MukhanovaE/Nano_sample_holders/README.md

Cable schematic
