MukhanovaE/Nano_sample_holders/support_angle/README.md

изображение
