MukhanovaE/Nano_sample_holders/holders_2023/README.md

SH1
