MukhanovaE/Nano_sample_holders/PCBs/12_pins/README.md

изображение
