MukhanovaE/Nano_sample_holders/PCBs/4_pin/README.md

PCBs for 4-pin holder:

  5 mm chip
  
  7 mm chip

изображение
