MukhanovaE/Nano_sample_holders/PCBs/8_pins/README.md

8 pins holder:

  5 mm chip (original design of 2023)
  
  7 mm chip

изображение
