MukhanovaE/Nano_sample_holders/holders_2023/holders_description.txt

1st generation: ---2023--- 

  8-pin holder: fabricated in nanotalo workshop
