MukhanovaE/Nano_sample_holders/holders_2023/8_pins_1st_generation/8pins_bottom_part_holder.stp

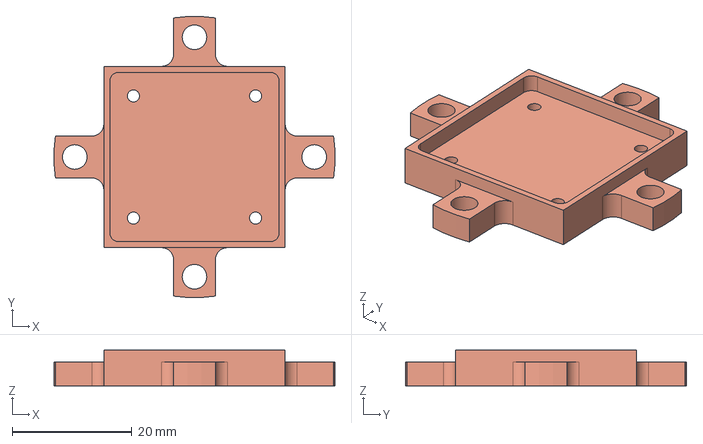
[picture p9: CAD file, 2024-10-09]
holders_2023/8_pins_1st_generation/8pins_bottom_part_holder.stp
46.9 x 46.9 x 6.00 mm
