MukhanovaE/Nano_sample_holders/mu_shields/lid_for_mu_shield_2_sizes.SLDPRT

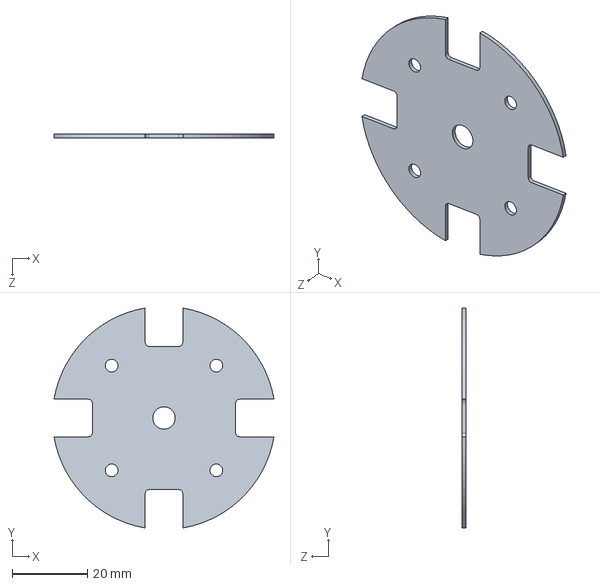
[picture p10: CAD file, 2024-09-30]
mu_shields/lid_for_mu_shield_2_sizes.SLDPRT
58.7 x 58.7 x 1.02 mm
