MukhanovaE/Nano_sample_holders/PCBs/12_pins/PCB_7x7_12pins.DXF

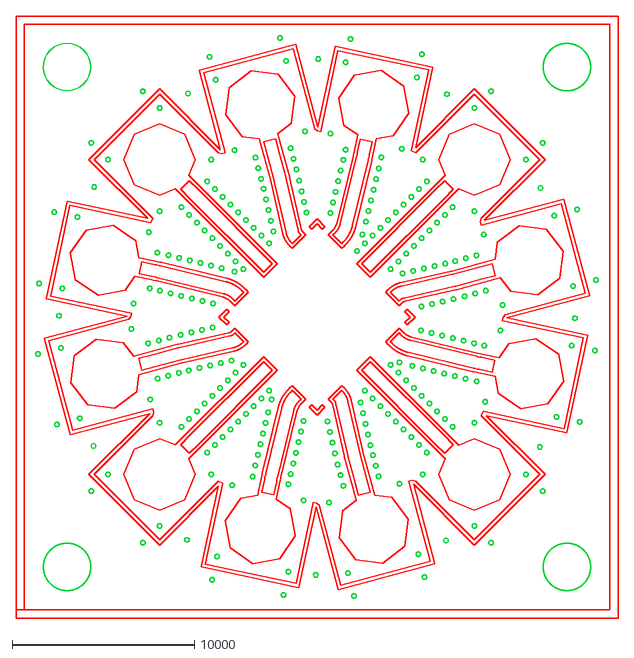
[picture p11: CAD file, 2024-09-30]
PCBs/12_pins/PCB_7x7_12pins.DXF
33000.0 x 33000.0
