MukhanovaE/Nano_sample_holders/PCBs/4_pin/PCB_7x7_4pins.dxf

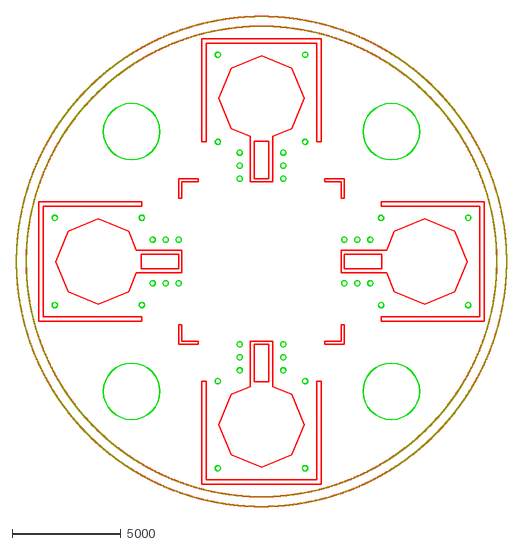
[picture p12: CAD file, 2024-09-30]
PCBs/4_pin/PCB_7x7_4pins.dxf
22500.0 x 22500.0
