MukhanovaE/Nano_sample_holders/PCBs/8_pins/PCB_5x5_8pins_submittef.dxf

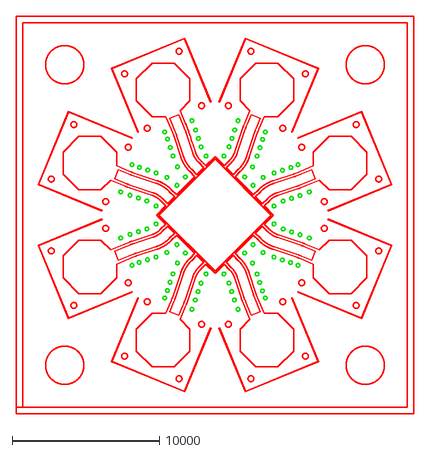
[picture p13: CAD file, 2024-09-30]
PCBs/8_pins/PCB_5x5_8pins_submittef.dxf
27000.0 x 27000.0
