MukhanovaE/Nano_sample_holders/shield_copper_mount_base/mount_base.SLDPRT

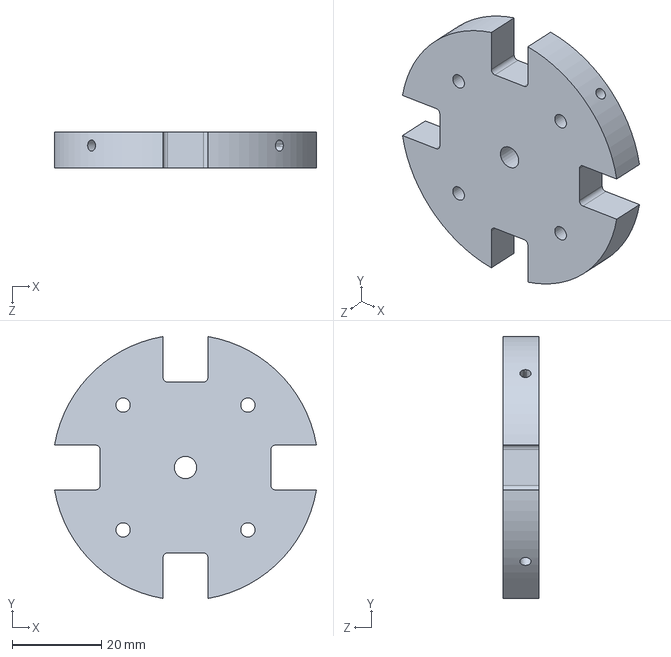
[picture p14: CAD file, 2024-09-30]
shield_copper_mount_base/mount_base.SLDPRT
58.7 x 58.7 x 8.00 mm
