MukhanovaE/Nano_sample_holders/support_angle/angle_mount.SLDPRT

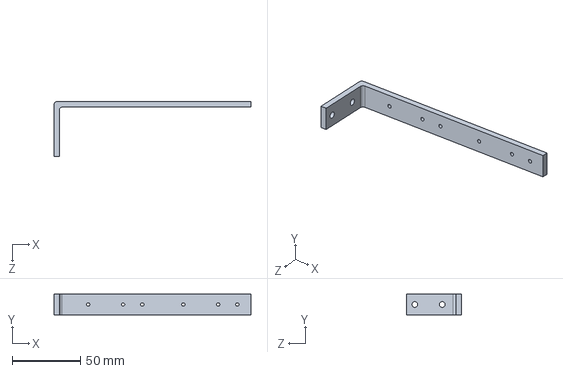
[picture p15: CAD file, 2024-09-30]
support_angle/angle_mount.SLDPRT
144.0 x 15.0 x 40.0 mm
