MukhanovaE/Nano_sample_holders/holders_2023/8_pins_1st_generation/8pins_top_part_holder.stp

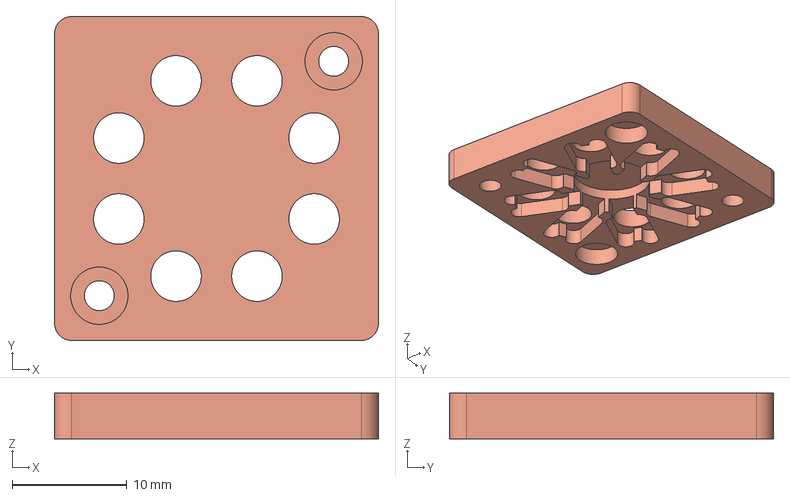
[picture p16: CAD file, 2024-10-09]
holders_2023/8_pins_1st_generation/8pins_top_part_holder.stp
28.2 x 28.2 x 4.00 mm
