MukhanovaE/Nano_sample_holders/mu_shields/mu_shield_2_sizes.SLDPRT

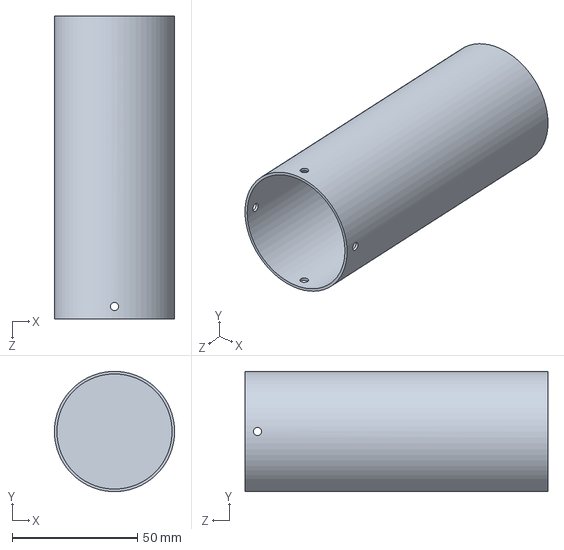
[picture p17: CAD file, 2024-09-30]
mu_shields/mu_shield_2_sizes.SLDPRT
48.0 x 48.0 x 121.0 mm
