MukhanovaE/Nano_sample_holders/PCBs/12_pins/PCB_10x10_12pins.DXF

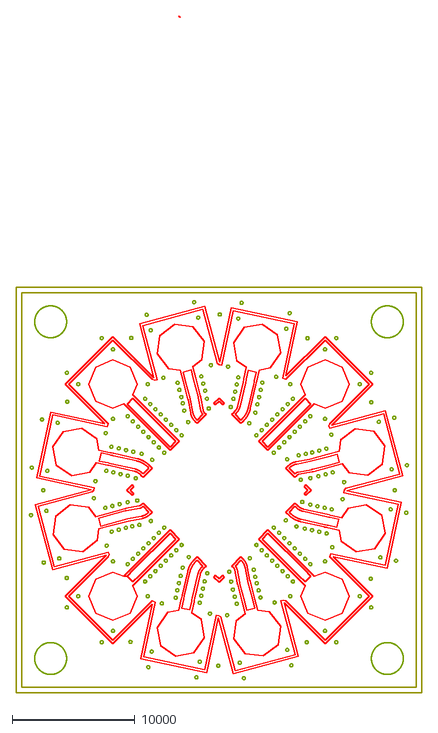
[picture p18: CAD file, 2024-09-30]
PCBs/12_pins/PCB_10x10_12pins.DXF
33000.0 x 55075.8
