MukhanovaE/Nano_sample_holders/PCBs/4_pin/PCB_5x5_4pins.DXF

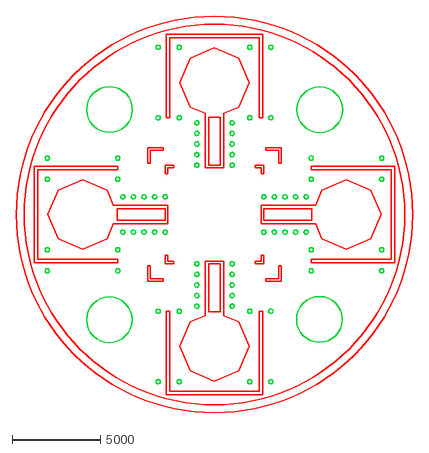
[picture p19: CAD file, 2024-09-30]
PCBs/4_pin/PCB_5x5_4pins.DXF
22500.0 x 22500.0
