MukhanovaE/Nano_sample_holders/PCBs/8_pins/PCB_7x7_8pins.dxf

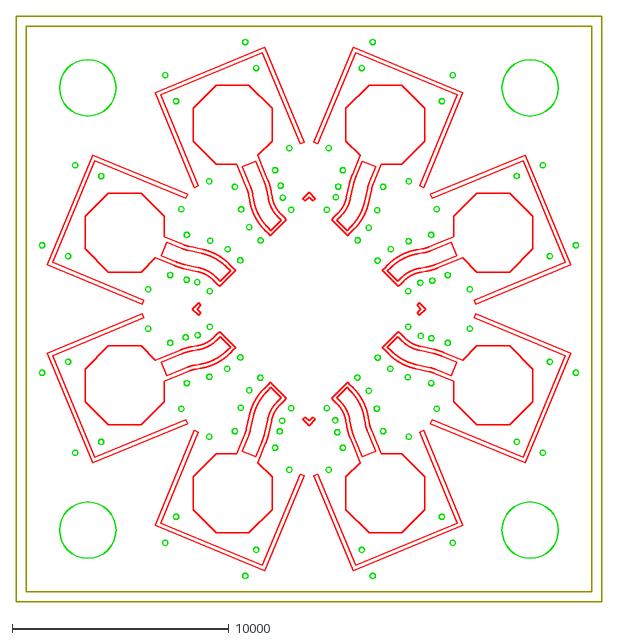
[picture p20: CAD file, 2024-09-30]
PCBs/8_pins/PCB_7x7_8pins.dxf
27000.0 x 27000.0
