MukhanovaE/Nano_sample_holders/(list of files, cad)

Other CAD files:
holders_2023/8_pins_1st_generation/Connector.ipt
holders_2023/8_pins_1st_generation/Connector_MIR.ipt
holders_2023/8_pins_1st_generation/PCB.ipt
holders_2023/8_pins_1st_generation/PCB_ASSY.iam
support_angle/angle_mount_inner.SLDDRW
