MukhanovaE/Nano_sample_holders/support_angle/angle_mount_inner.pdf

E E

F F

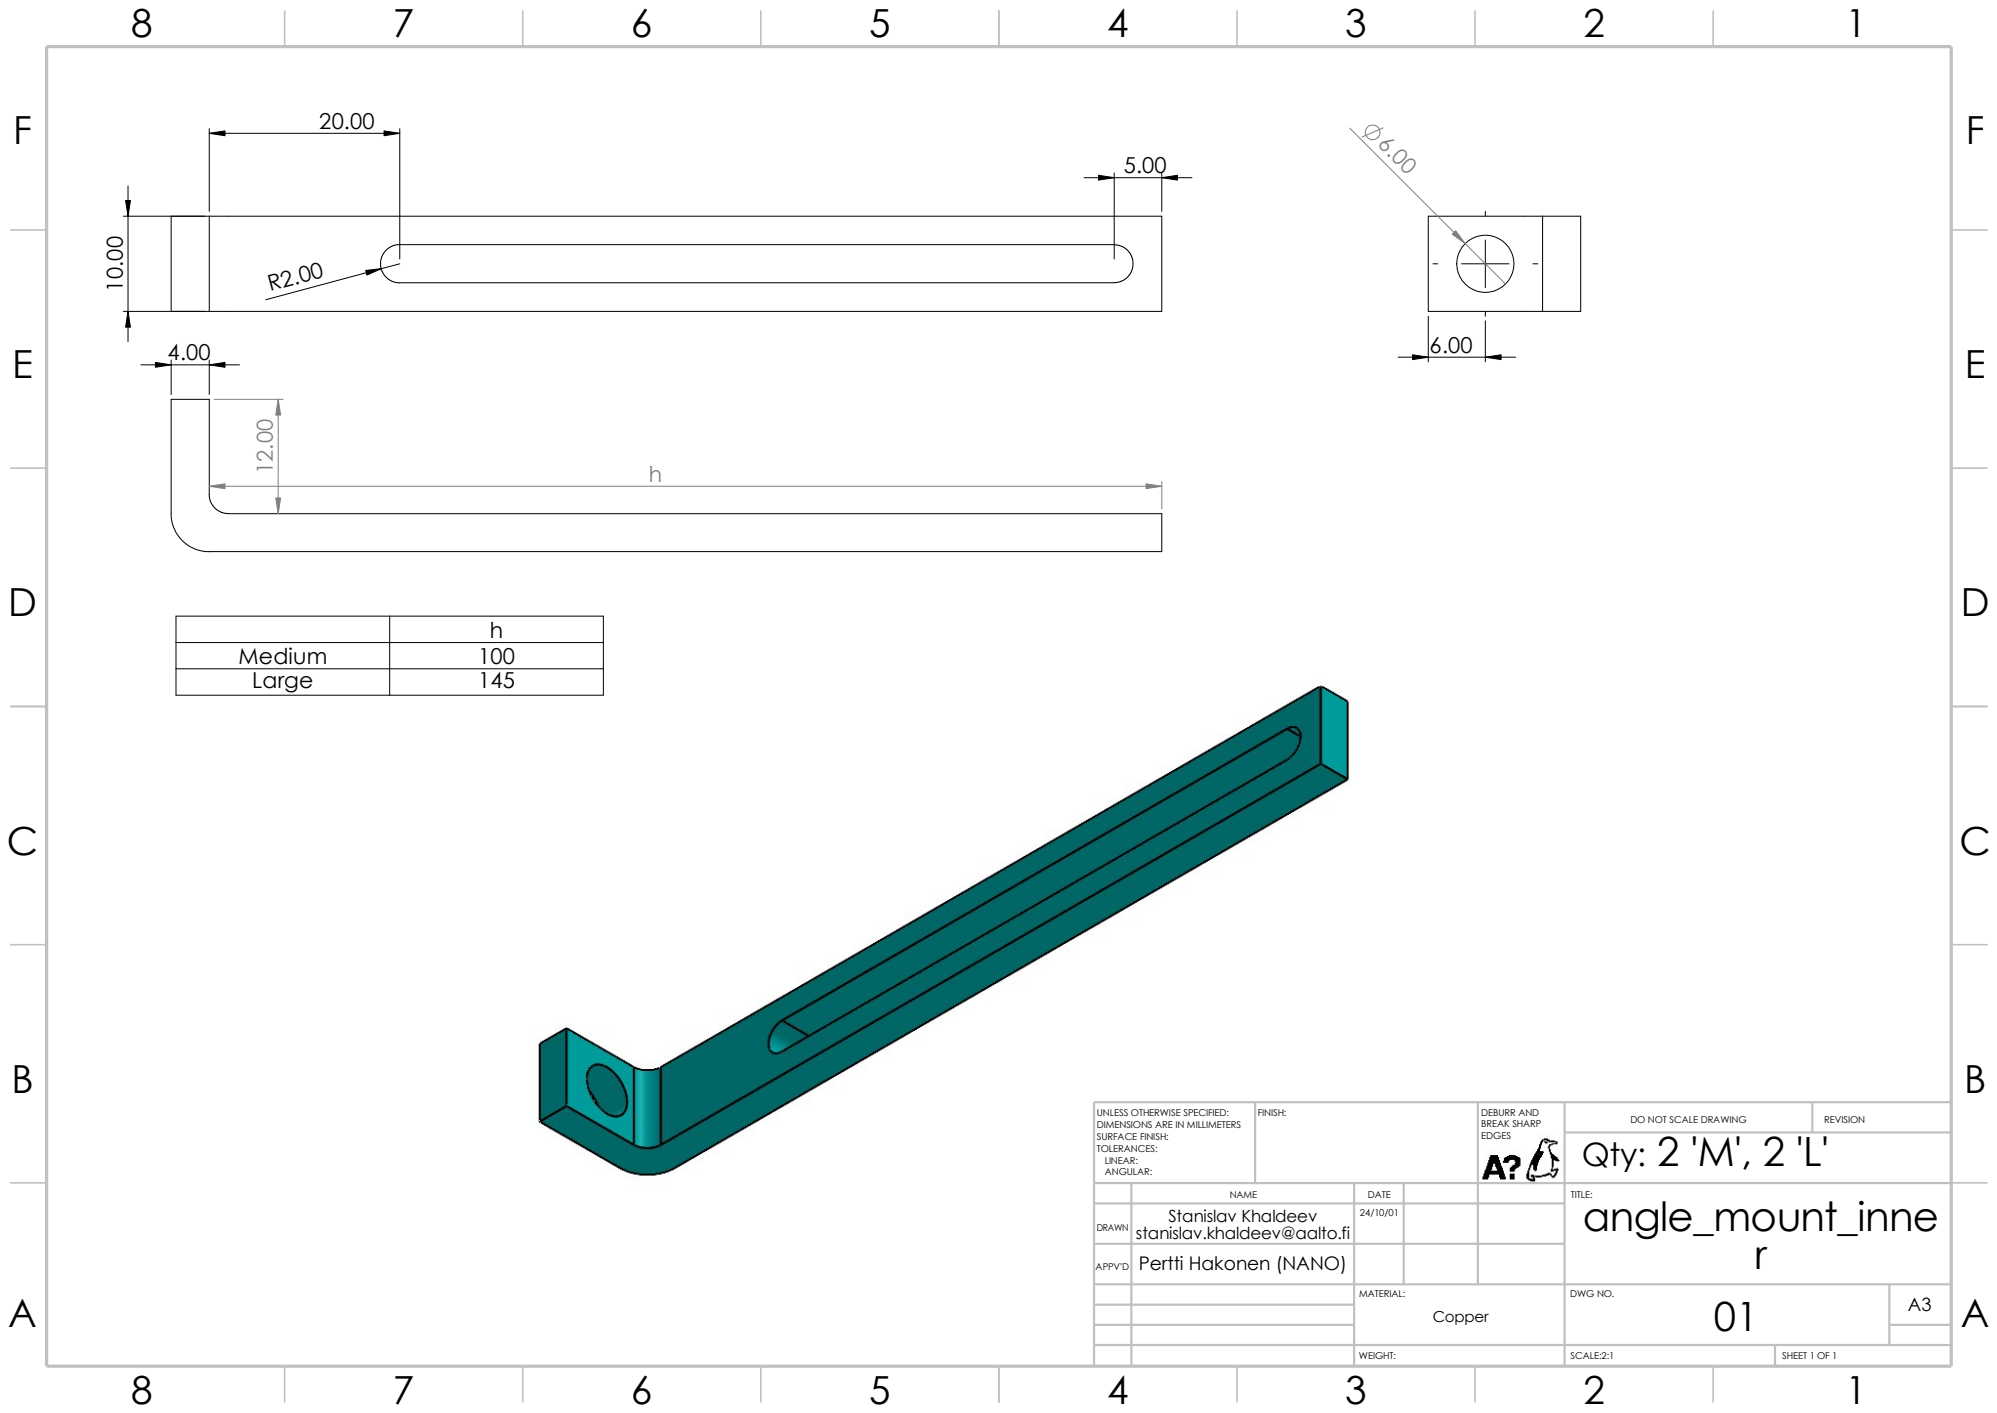
[picture p21: page 1]
Qty:; FINISH:; EDGES; DO NOT SCALE DRAWING; REVISION; BREAK SHARP; DEBURR AND

Medium | 100
Large | 145

UNLESS OTHERWISE SPECIFIED:
DIMENSIONS ARE IN MILLIMETERS
SURFACE FINISH:
TOLERANCES:
LINEAR:
ANGULAR:

NAME | DATE | | | TITLE: angle_mount_inne r
DRAWN | Stanislav Khaldeev stanislav.khaldeev@aalto.fi | 24/10/01

APPV'D | Pertti Hakonen (NANO)

MATERIAL: | DWG NO. 01 | A3 Copper

WEIGHT: | SCALE:2:1 | SHEET 1 OF 1
