MukhanovaE/Nano_sample_holders/mu_shields/shield_lid.pdf

E E

F F

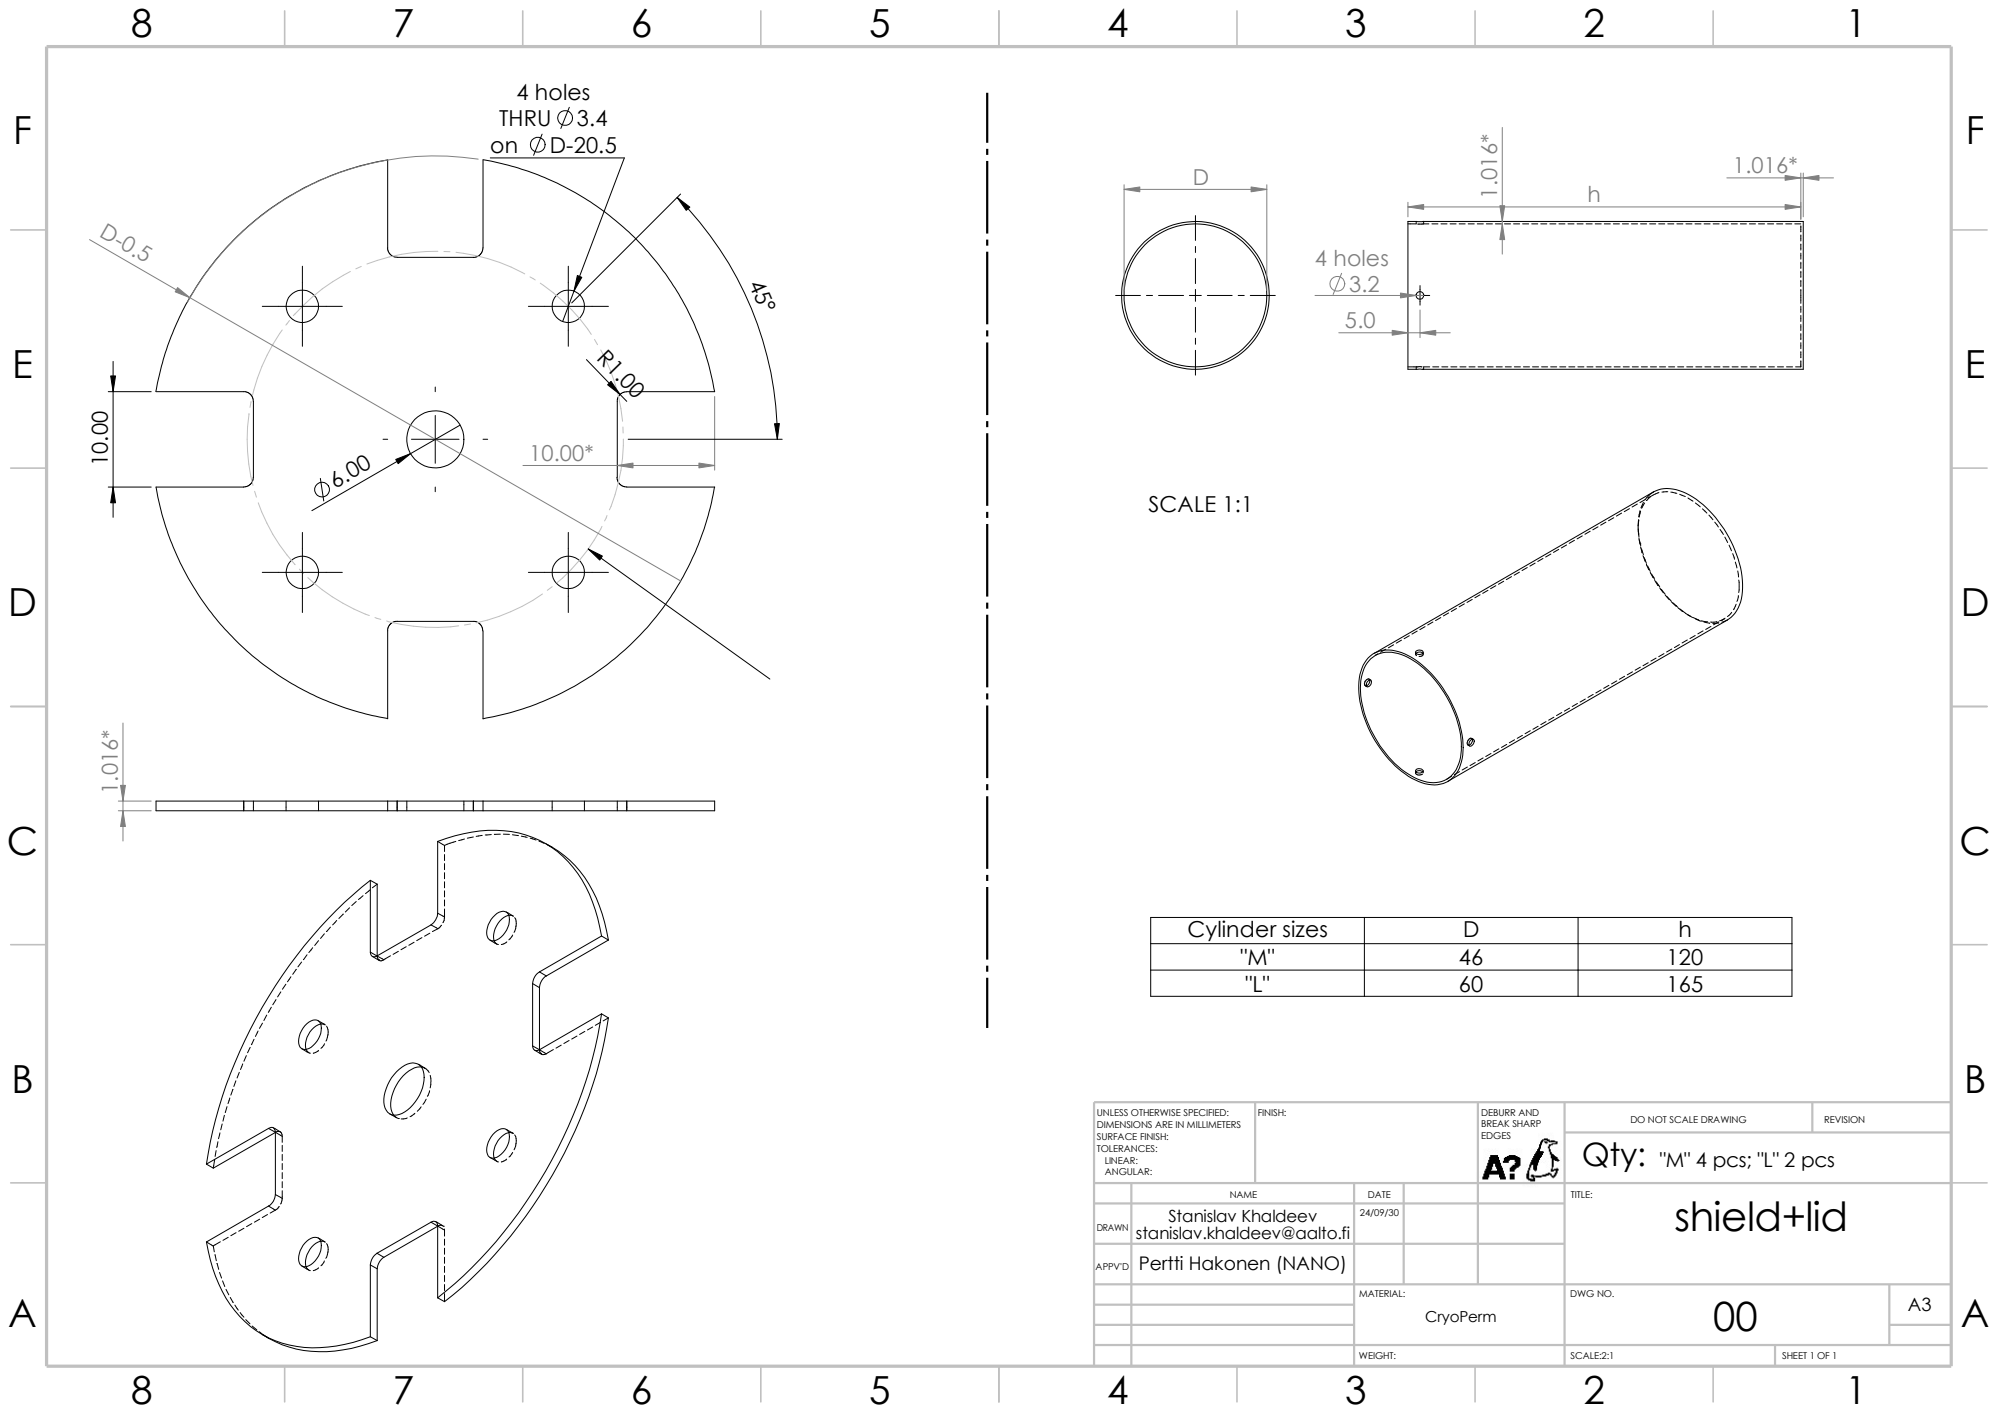
[picture p22: page 1]
ANGULAR:; WEIGHT:; FINISH:; EDGES; DO NOT SCALE DRAWING; REVISION; SCALE:2:1; SHEET 1 OF 1; LINEAR:; Qty:; BREAK SHARP; DEBURR AND; "M" 4 pcs; "L" 2 pcs; SCALE 1:1; 4 holes THRU 3.4 on; 4 holes

Cylinder sizes | D | h
"M" | 46 | 120
"L" | 60 | 165

UNLESS OTHERWISE SPECIFIED:
DIMENSIONS ARE IN MILLIMETERS
SURFACE FINISH:
TOLERANCES:

NAME | DATE | | | TITLE: shield+lid

DRAWN | Stanislav Khaldeev stanislav.khaldeev@aalto.fi | 24/09/30

APPV'D | Pertti Hakonen (NANO)

MATERIAL: CryoPerm | DWG NO. 00 | A3
