MukhanovaE/Nano_sample_holders/shield_copper_mount_base/copper_base.pdf

E E

F F

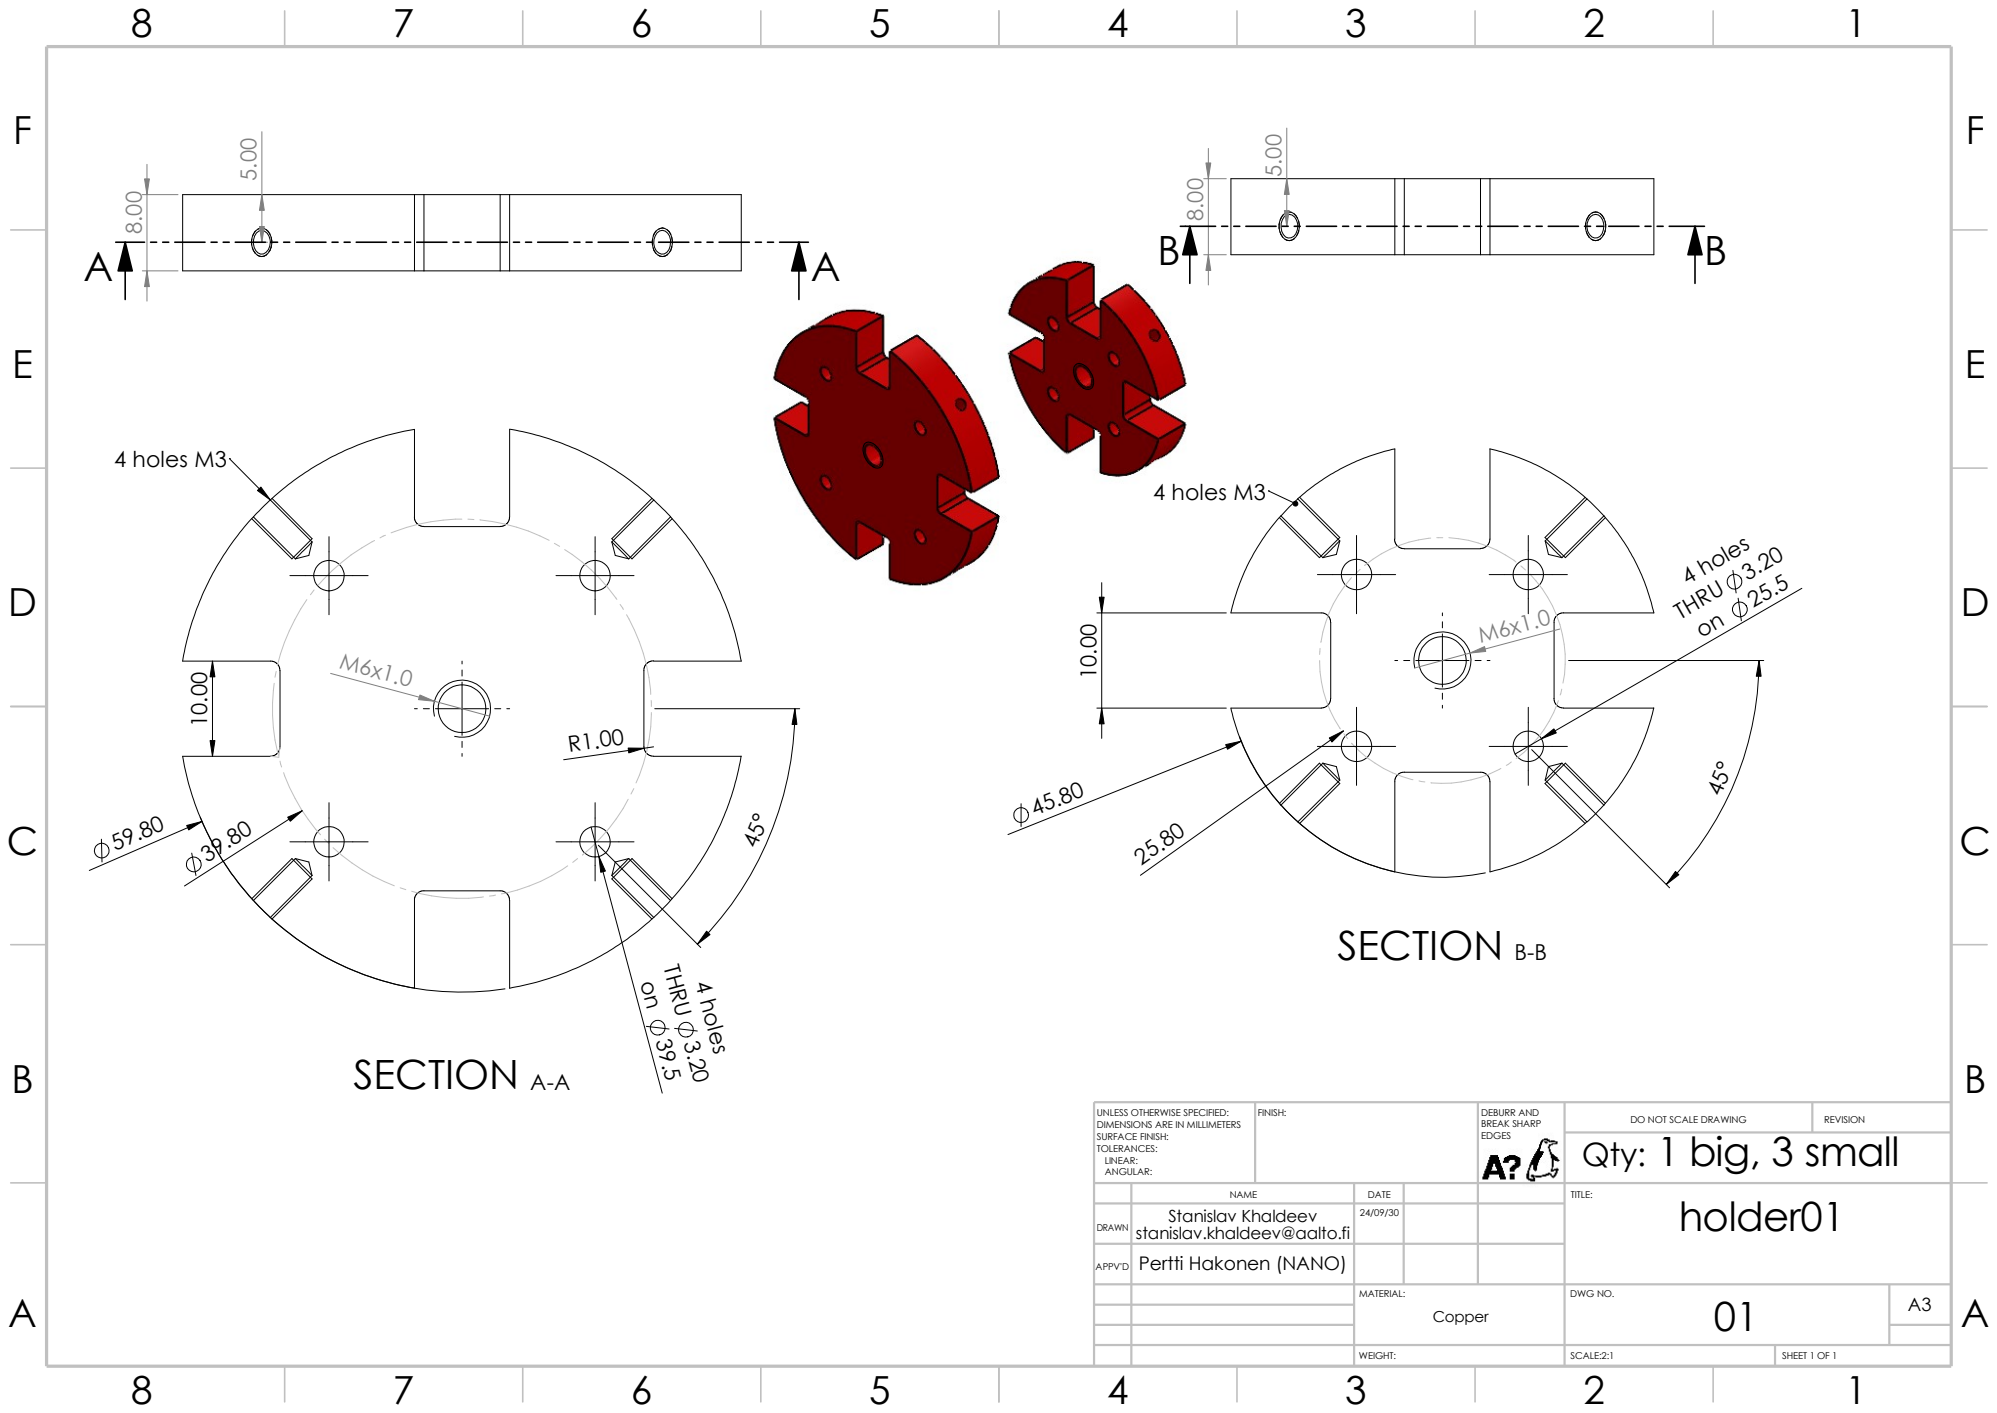
[picture p23: page 1]
Qty:; FINISH:; EDGES; DO NOT SCALE DRAWING; REVISION; BREAK SHARP; DEBURR AND; 1 big, 3 small ⁸.00; SECTION A-A; 4 holes M3; 4 holes; THRU; SECTION B-B; 4 holes THRU 3.20

UNLESS OTHERWISE SPECIFIED:
DIMENSIONS ARE IN MILLIMETERS
SURFACE FINISH:
TOLERANCES:
LINEAR:
ANGULAR:

NAME | DATE | | | TITLE: holder01

DRAWN | Stanislav Khaldeev stanislav.khaldeev@aalto.fi | 24/09/30

APPV'D | Pertti Hakonen (NANO)

MATERIAL: | DWG NO. 01 | A3 Copper

WEIGHT: | SCALE:2:1 | SHEET 1 OF 1
