MukhanovaE/Nano_sample_holders/support_angle/angle_mount.pdf

E E

F F

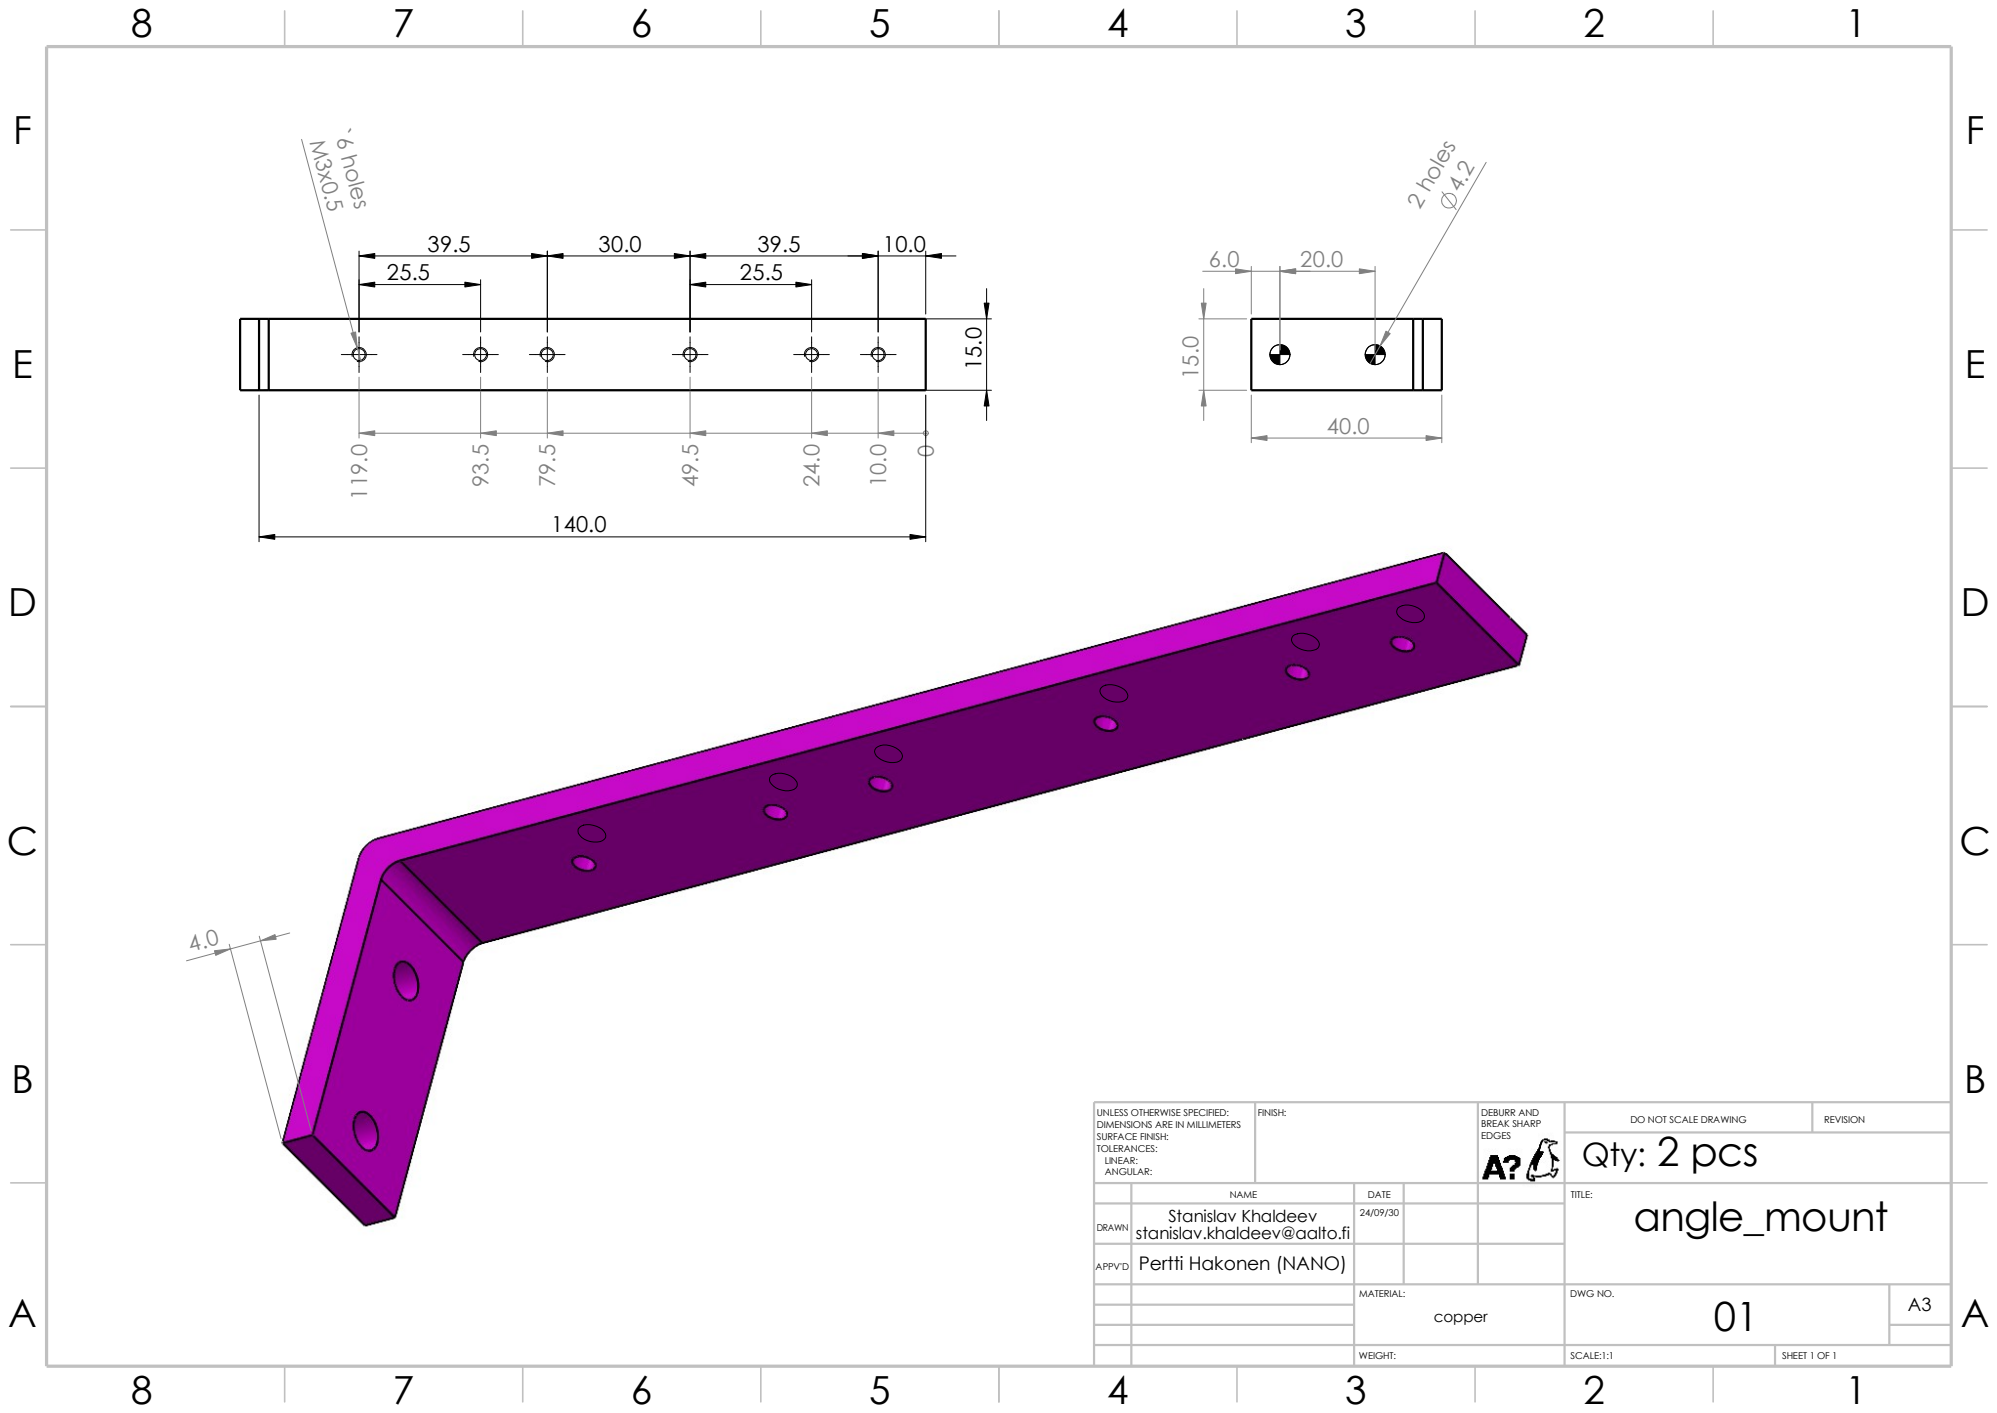
[picture p24: page 1]
WEIGHT:; FINISH:; EDGES; DO NOT SCALE DRAWING; REVISION; SCALE:1:1; Qty:; SHEET 1 OF 1; BREAK SHARP; DEBURR AND; 2 pcs; `6 holes M3x0.5 15.0; 2 holes 4.2

UNLESS OTHERWISE SPECIFIED:
DIMENSIONS ARE IN MILLIMETERS
SURFACE FINISH:
TOLERANCES:
LINEAR:
ANGULAR:

NAME | DATE | | | TITLE: angle_mount

DRAWN | Stanislav Khaldeev stanislav.khaldeev@aalto.fi | 24/09/30

APPV'D | Pertti Hakonen (NANO)

MATERIAL: copper | DWG NO. | A3
