MukhanovaE/Nano_sample_holders/holders_2023/8_pins_1st_generation/8_pins_1st_generation_full_assambly.pdf

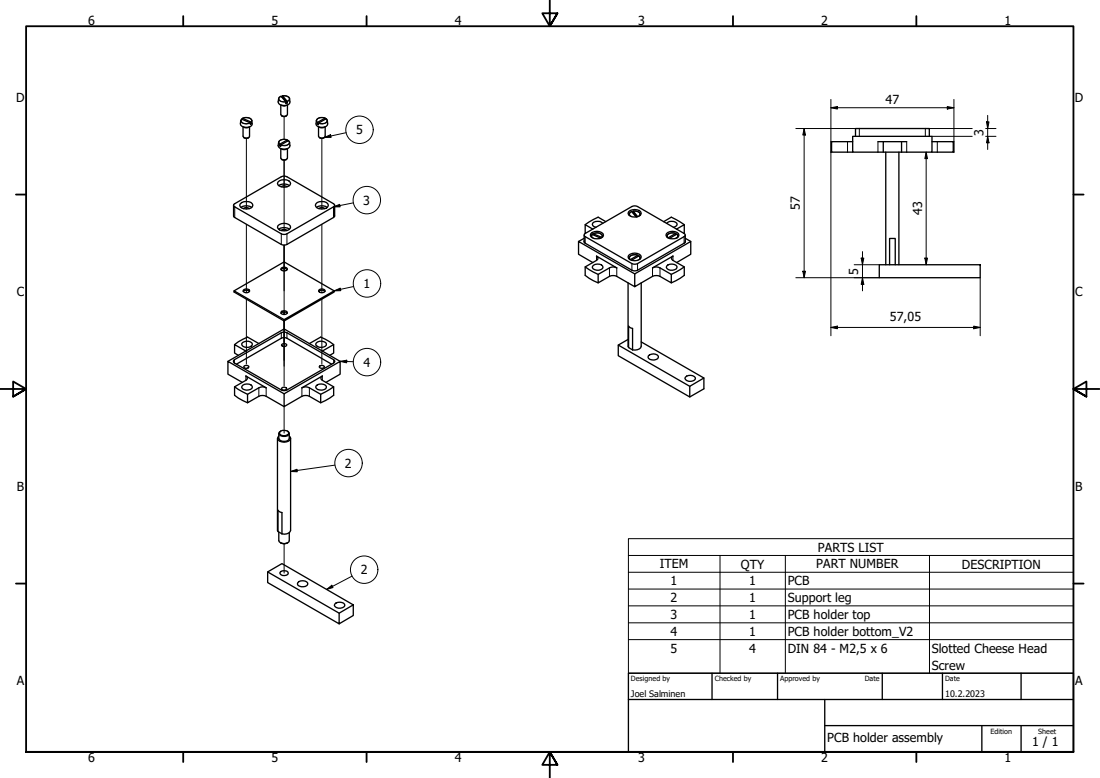
[picture p25: page 1]
PARTS LIST

ITEM | QTY | PART NUMBER | DESCRIPTION
1 | 1 | PCB
2 | 1 | Support leg
3 | 1 | PCB holder top
4 | 1 | PCB holder bottom_V2
5 | 4 | DIN 84 - M2,5 x 6 | Slotted Cheese Head Screw

Designed by Joel Salminen | Checked by | Approved by Date | | Date 10.2.2023

PCB holder assembly
