MukhanovaE/Nano_sample_holders/holders_2024/4_pin/4_pins_full.pdf

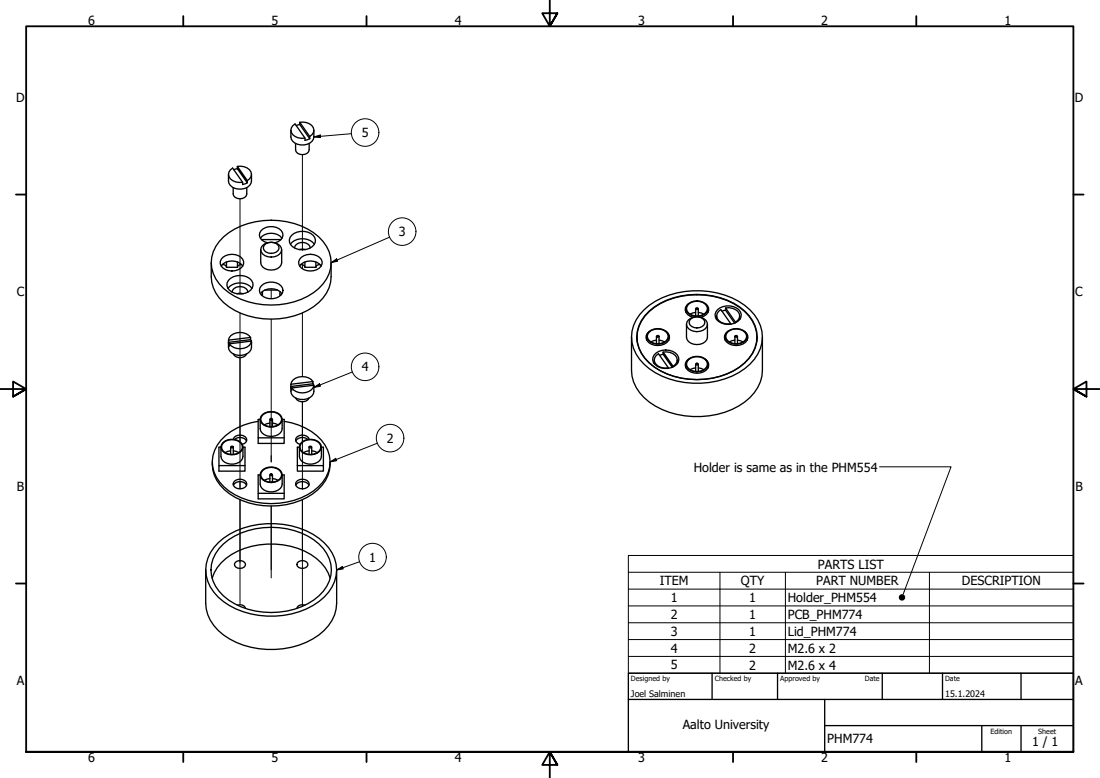
[picture p26: page 1]
PARTS LIST

Holder is same as in the PHM554

ITEM | QTY | PART NUMBER | DESCRIPTION
1 | 1 | Holder_PHM554
2 | 1 | PCB_PHM774
3 | 1 | Lid_PHM774
4 | 2 | M2.6 x 2
5 | 2 | M2.6 x 4

Designed by Joel Salminen | Checked by | Approved by Date | | Date 15.1.2024

Aalto University

PHM774 | Edition | Sheet 1 / 1
