MukhanovaE/Nano_sample_holders/support_column/Support_block_for_original_holder.pdf

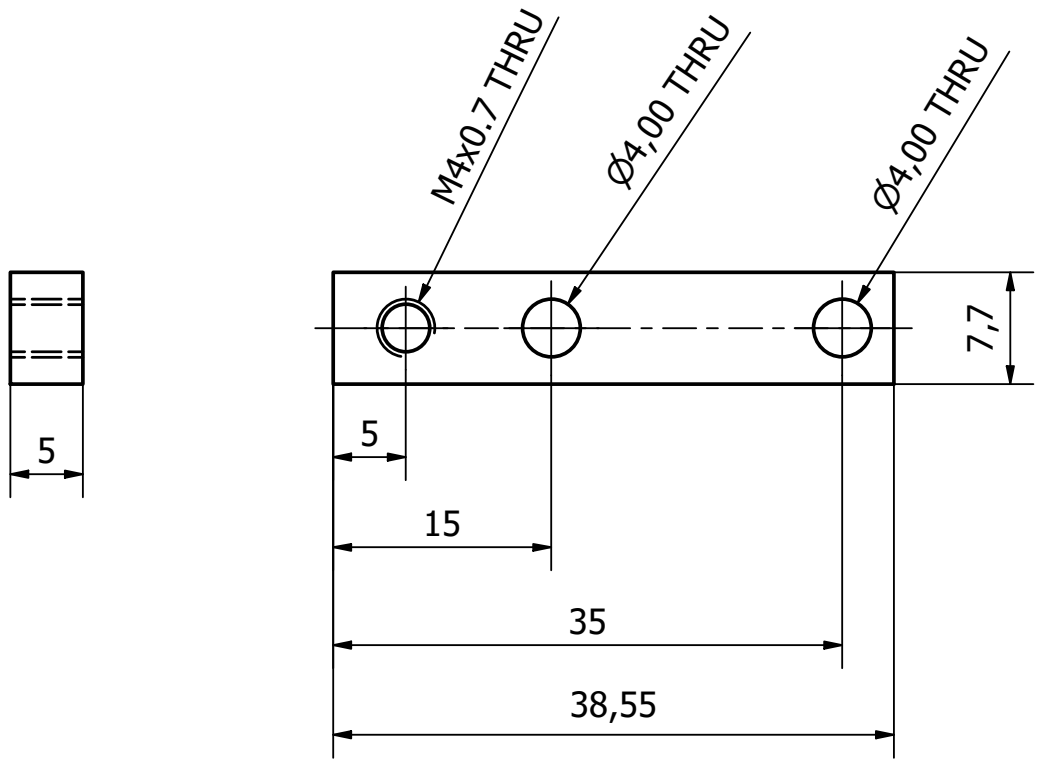
[picture p27: page 1]
Support block; Joel Salminen; Designed by; Checked by; Approved by; Date; M4x0.7 THRU; ⌀4,00 THRU; 00 THRU
