MukhanovaE/Nano_sample_holders/support_column/Support_column_for_original_holder.pdf

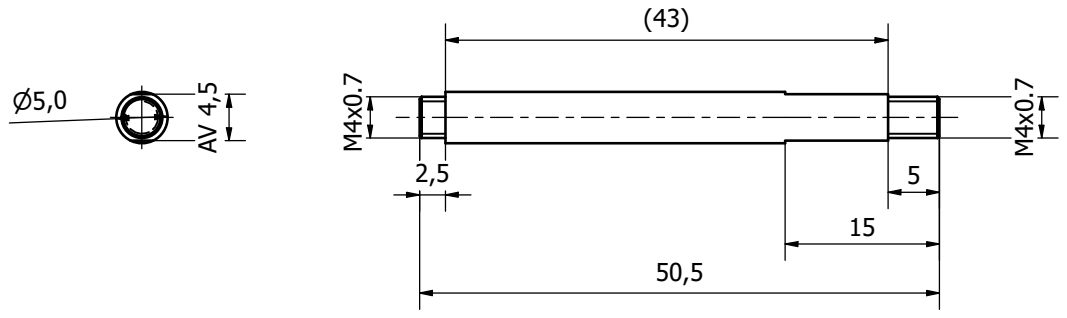
[picture p28: page 1]
Support column; Joel Salminen; Designed by; Checked by; Approved by; Date
