MukhanovaE/Nano_sample_holders/support_column/Support_column.pdf

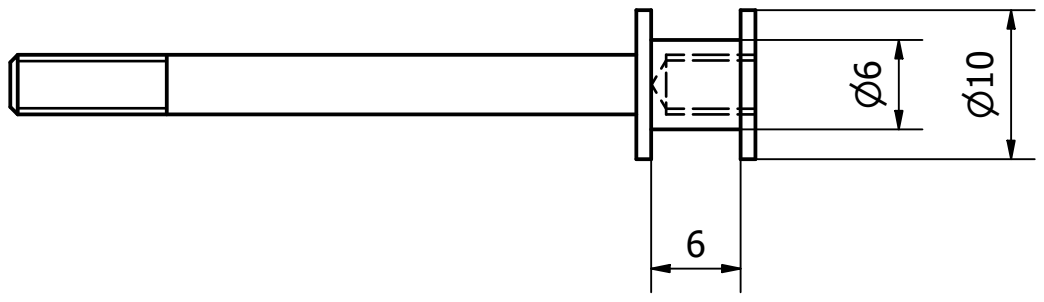
[picture p29: page 1]
Center post; Joel Salminen; Designed by; Checked by; Approved by; Date
