MukhanovaE/Nano_sample_holders/holders_2023/8_pins_1st_generation/8pins_bottom_part_holder.pdf

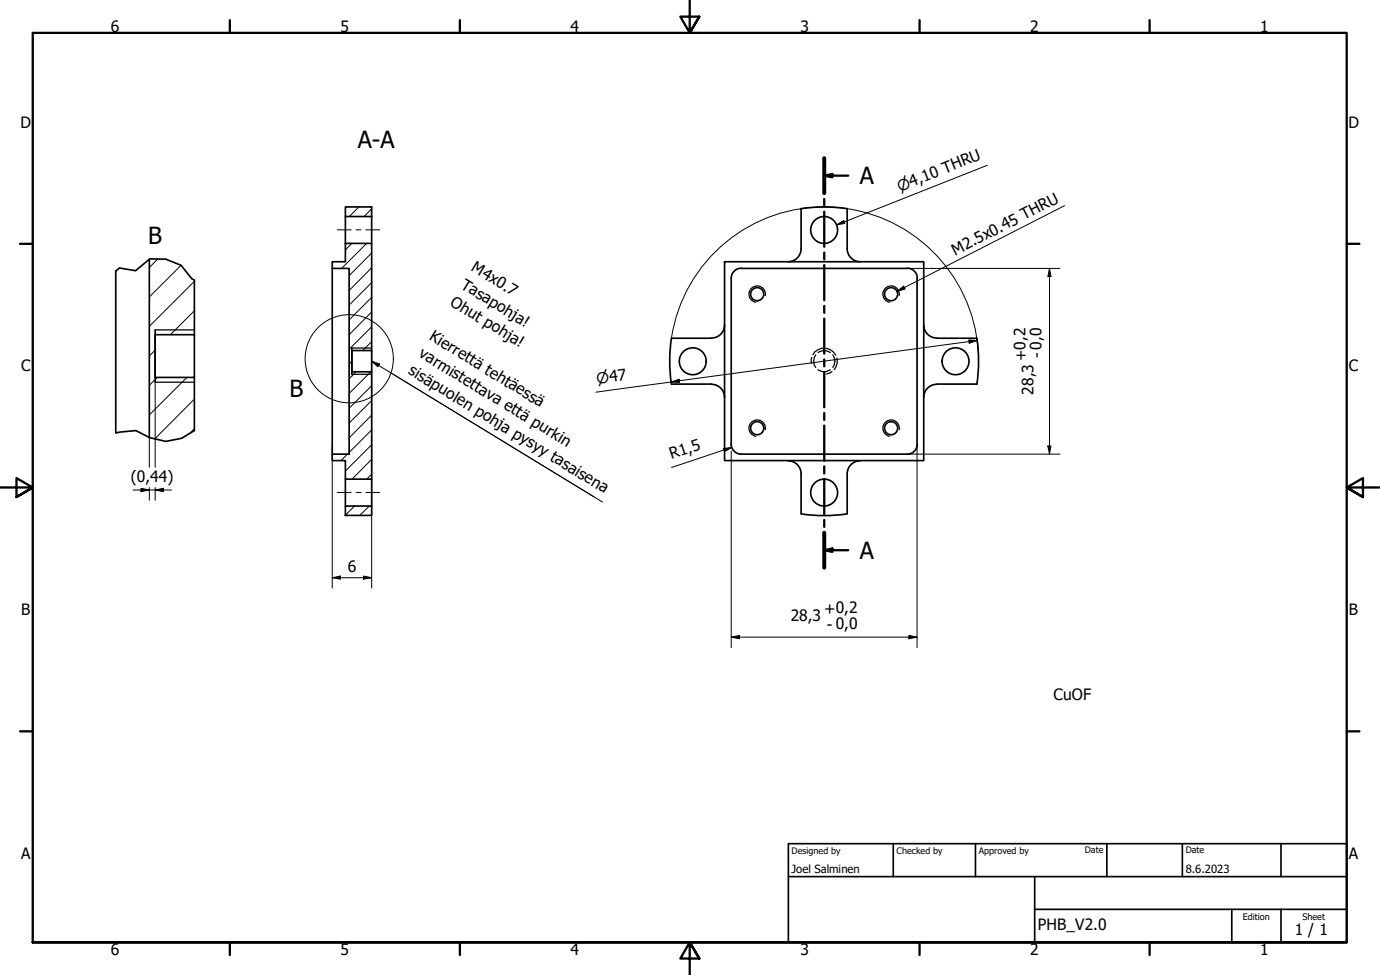
[picture p30: page 1]
Joel Salminen; Designed by; Checked by; Approved by; Date; ⌀4,10 THRU; M2.5x0.45 THRU; Ohut pohja!; Kierrettä tehtäessä

varmistettava että purkin

sisäpuolen pohja pysyy tasaisena
