MukhanovaE/Nano_sample_holders/holders_2023/8_pins_1st_generation/8pins_top_part_holder.pdf

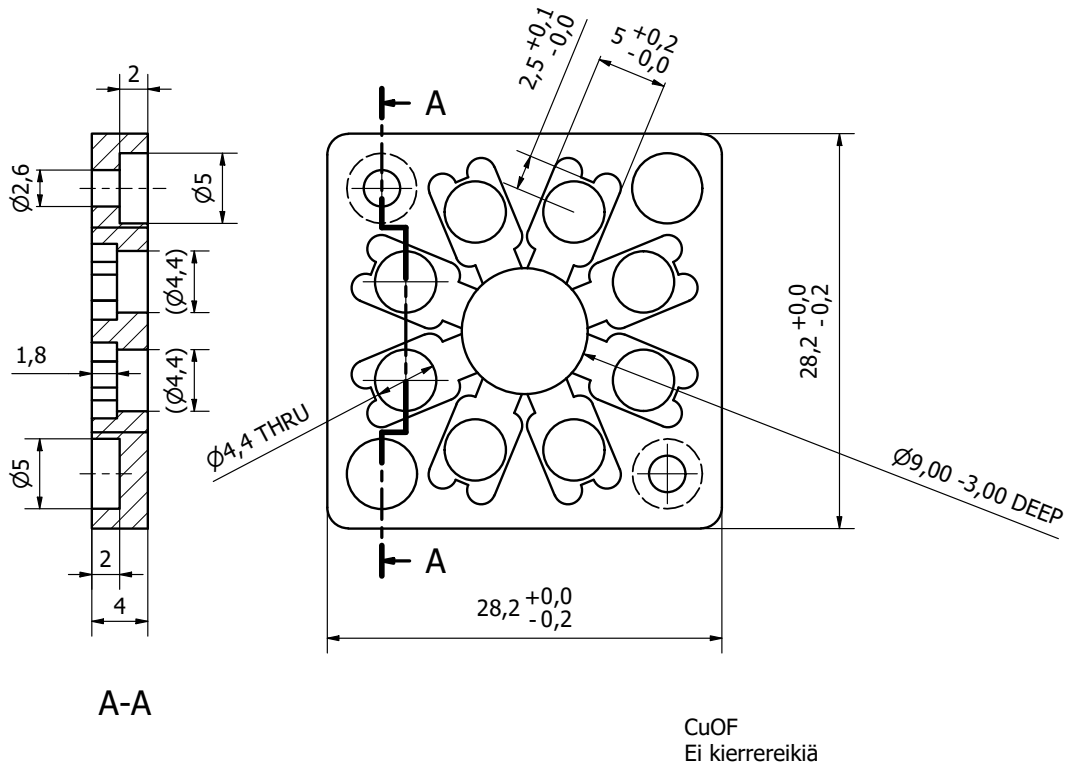
[picture p31: page 1]
Joel Salminen; Designed by; Checked by; Approved by; Date; ⌀4,4 THRU; Ei kierrereikiä; ⌀9,00 -3,00 DEEP
