MukhanovaE/Nano_sample_holders/holders_2024/4_pin/4_pin_p1.pdf

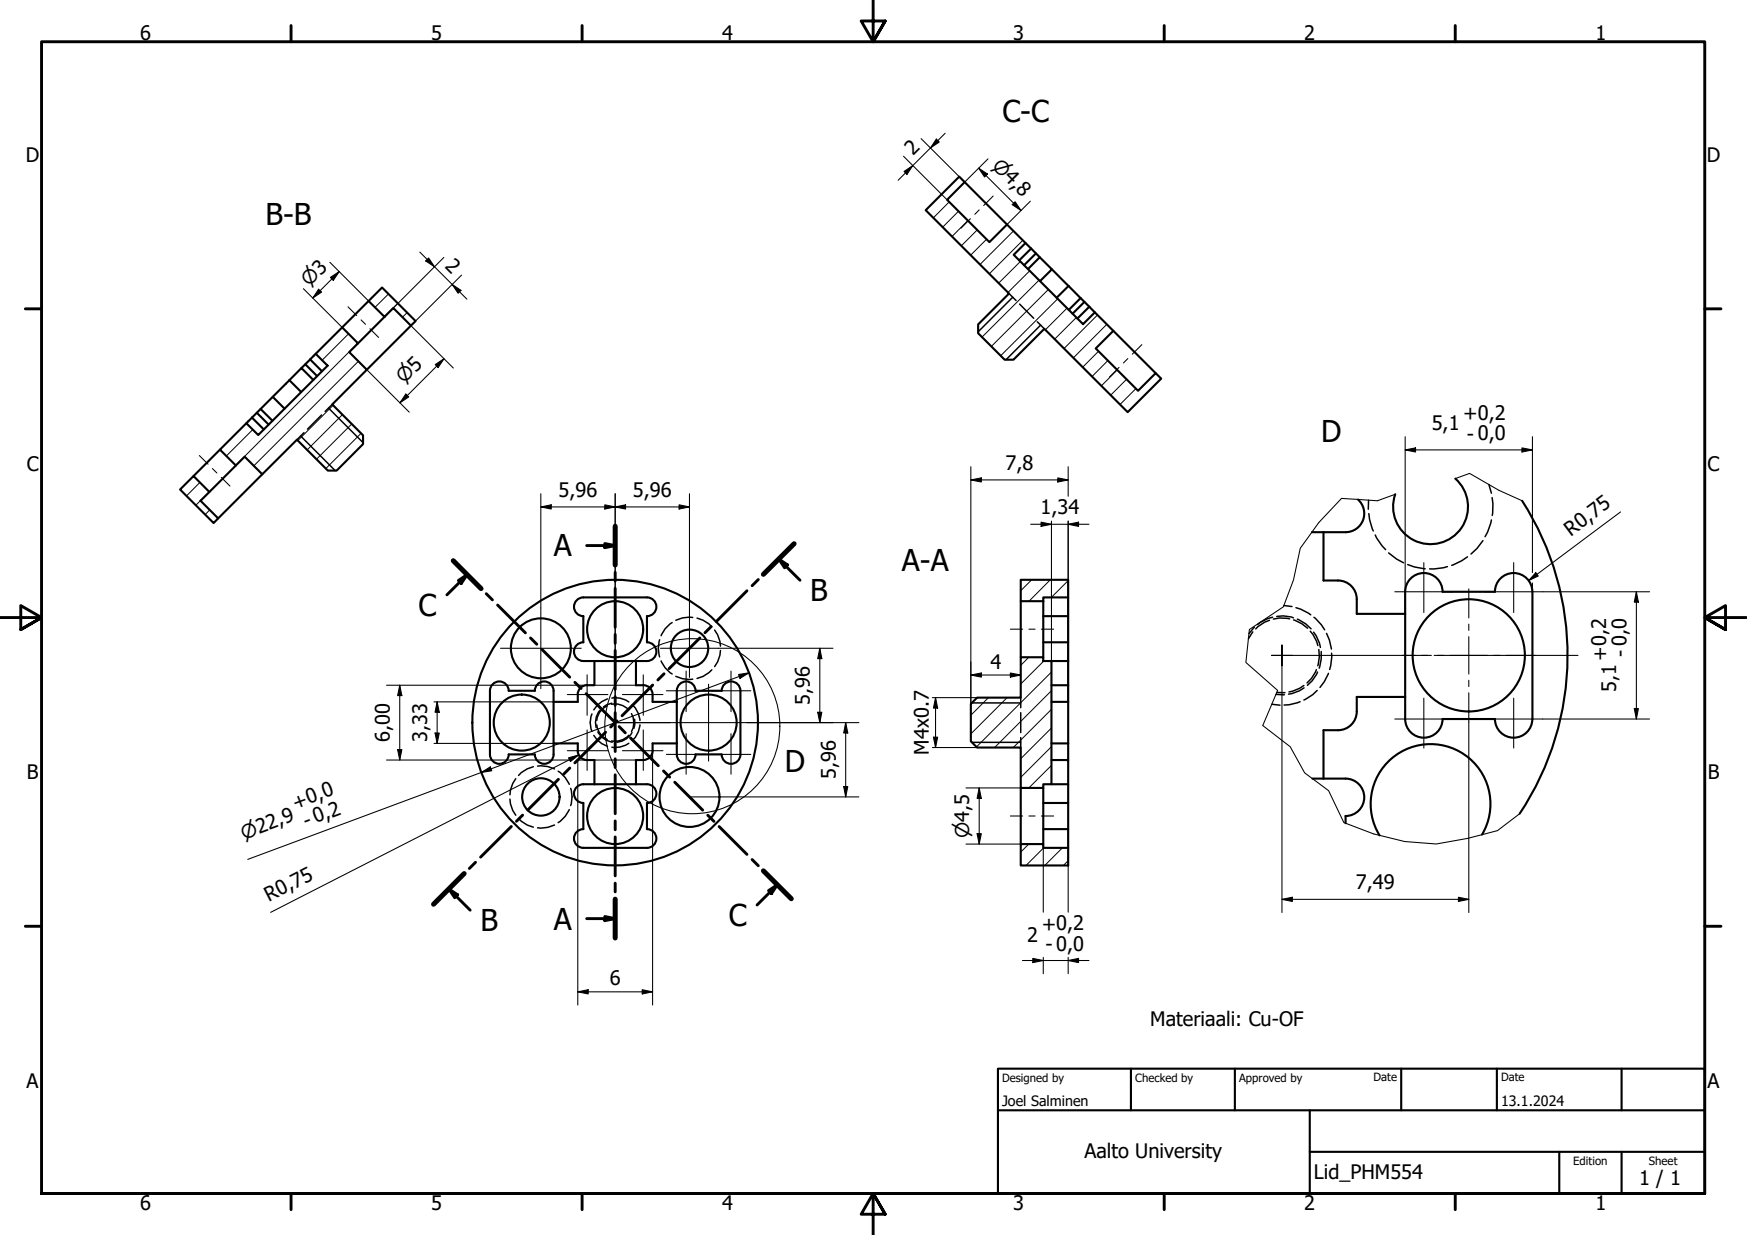
[picture p32: page 1]
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

A alt o U n i v e r s i t y
