MukhanovaE/Nano_sample_holders/holders_2024/4_pin/4_pin_holder.pdf

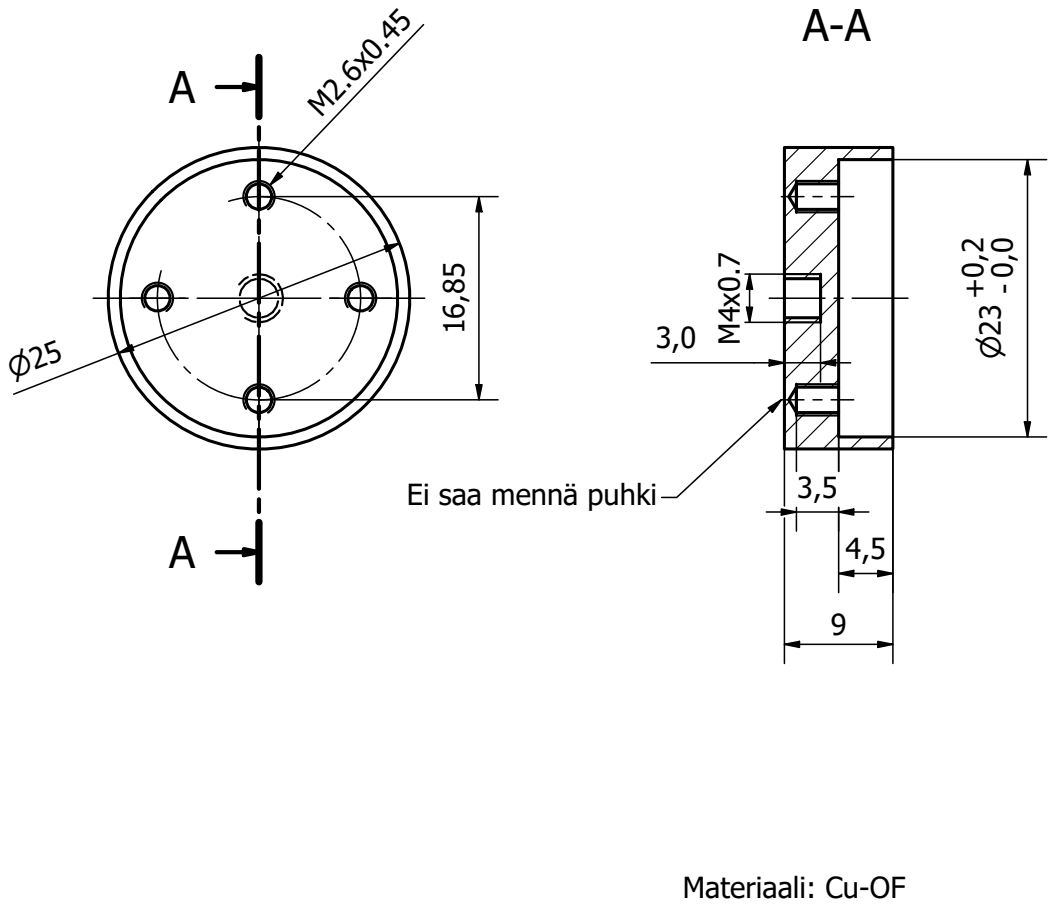
[picture p33: page 1]

Ei saa mennä puhki

Materiaali: Cu-OF

Designed by Joel Salminen | Checked by | Approved by Date | Date 15.1.2024

Aalto University

Holder_PHM554 | Edition | Sheet 1 / 1
