MukhanovaE/Nano_sample_holders/(commit log)

2024-09-30 SolidWorks file for support angle
    [angle_mount.SLDPRT]
2024-09-30 Add files via upload
    SolidWorks file with 2 mu-shields layout
    [mu_shield_2_sizes.SLDPRT]
2024-09-30 Add files via upload
    Lid with holes for wires for mu-metal shields in 2 sizes
    [lid_for_mu_shield_2_sizes.SLDPRT]
2024-09-30 Add files via upload
    angle mount schematic
